danielromila/CTCSS-encoder/schematic with Arduino Nano and Op Amp.jpg

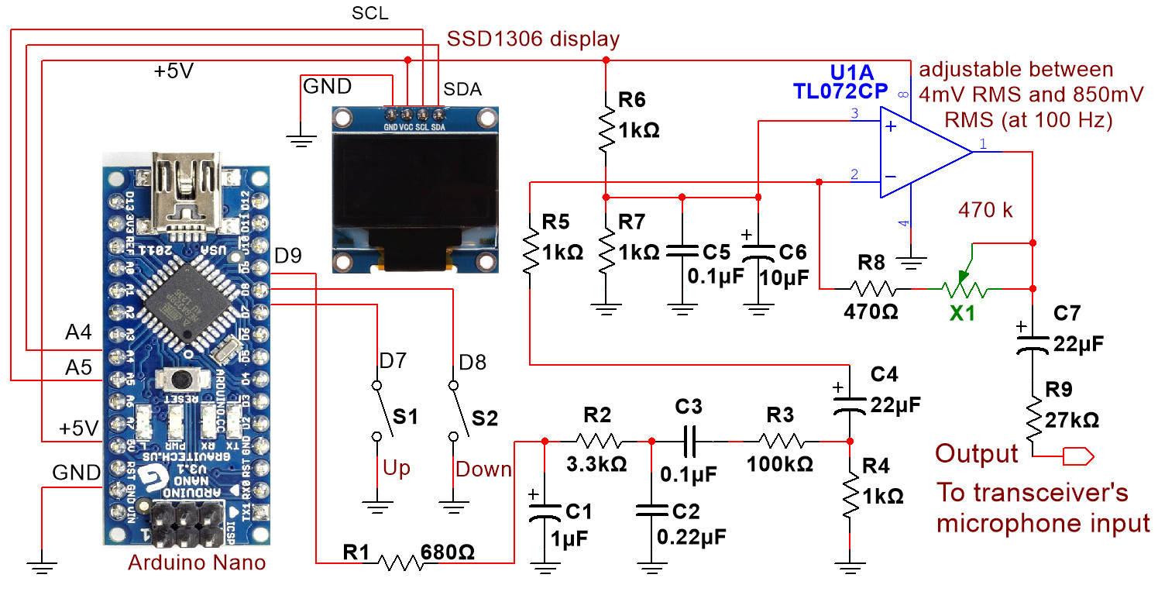
schematic with Arduino Nano and Op Amp.jpg
