danielromila/CTCSS-encoder/schematic with Arduino Nano.jpg

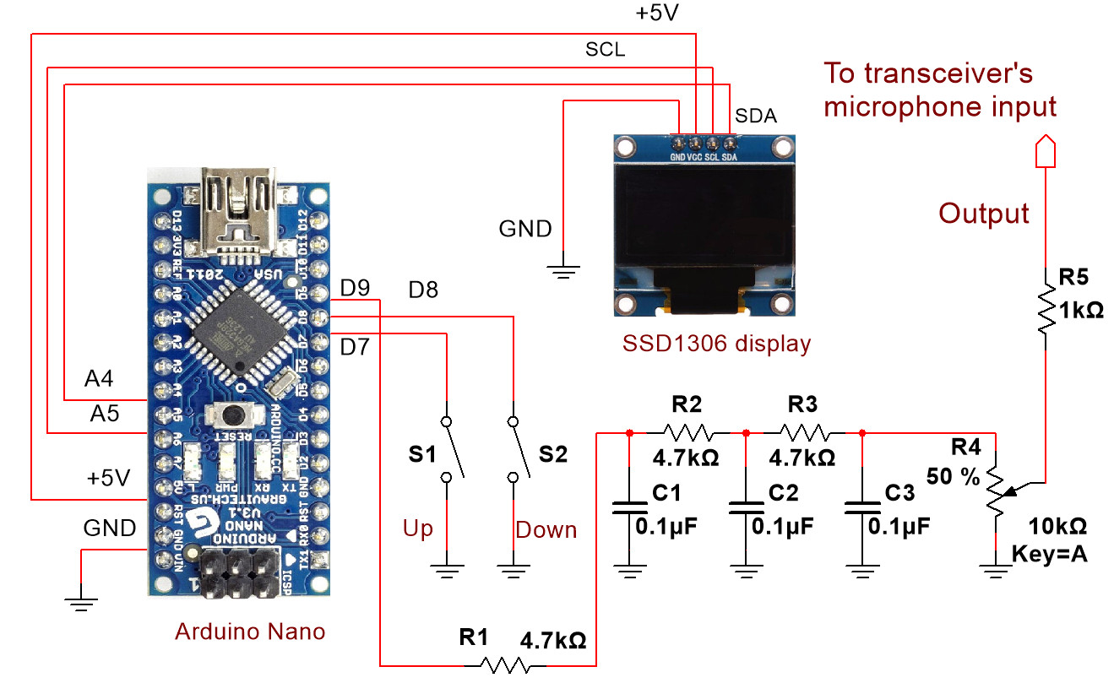
schematic with Arduino Nano.jpg
