danielromila/CTCSS-encoder/README.md

# CTCSS-encoder

The libraries used in this project are:
- Adafruit_BusIO
- Adafruit_SSD1306-master
- Adafruit-GFX-Library-master
