danielromila/CTCSS-encoder/p2.JPG

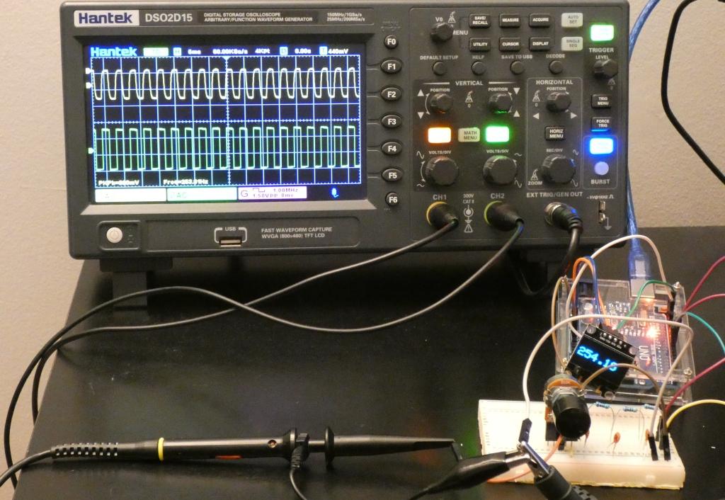
p2.JPG
