danielromila/CTCSS-encoder/version.jpg

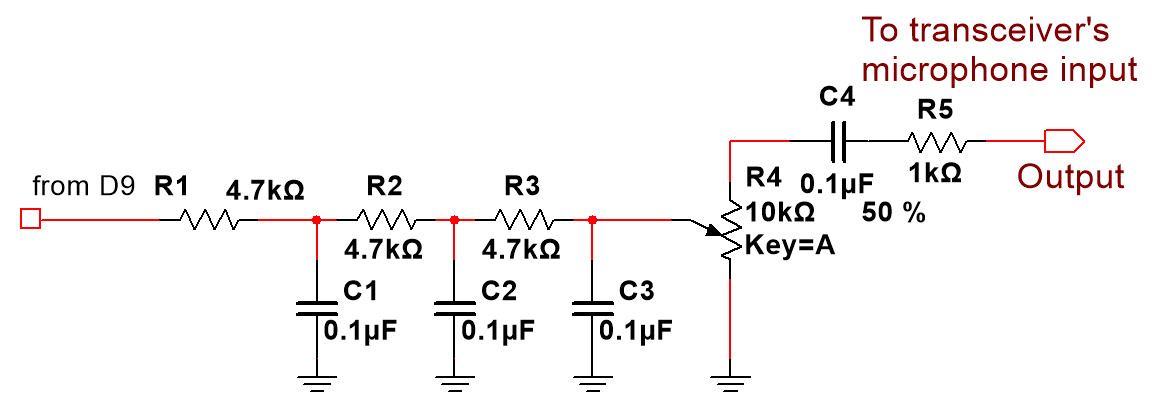
version.jpg
