danielromila/CTCSS-encoder/(list of files, drawings)

Other design files:
Design1.ms14
